BetaRavener/FITkit-plotter/Plotter/bottom.JPG

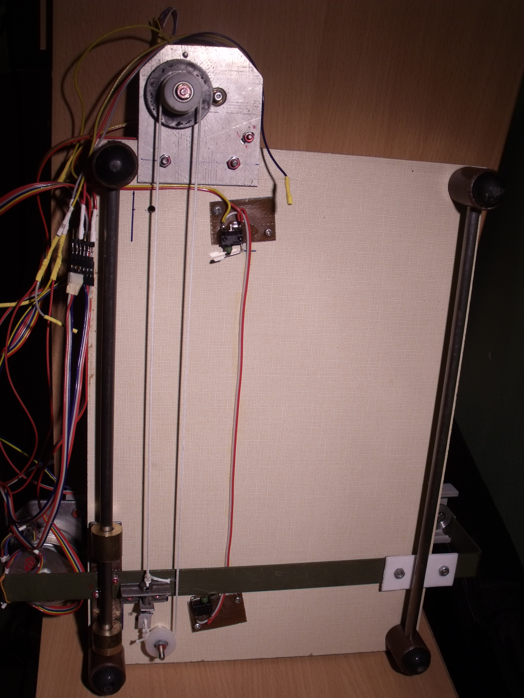
Plotter/bottom.JPG
