BetaRavener/FITkit-plotter/Plotter/stringY.JPG

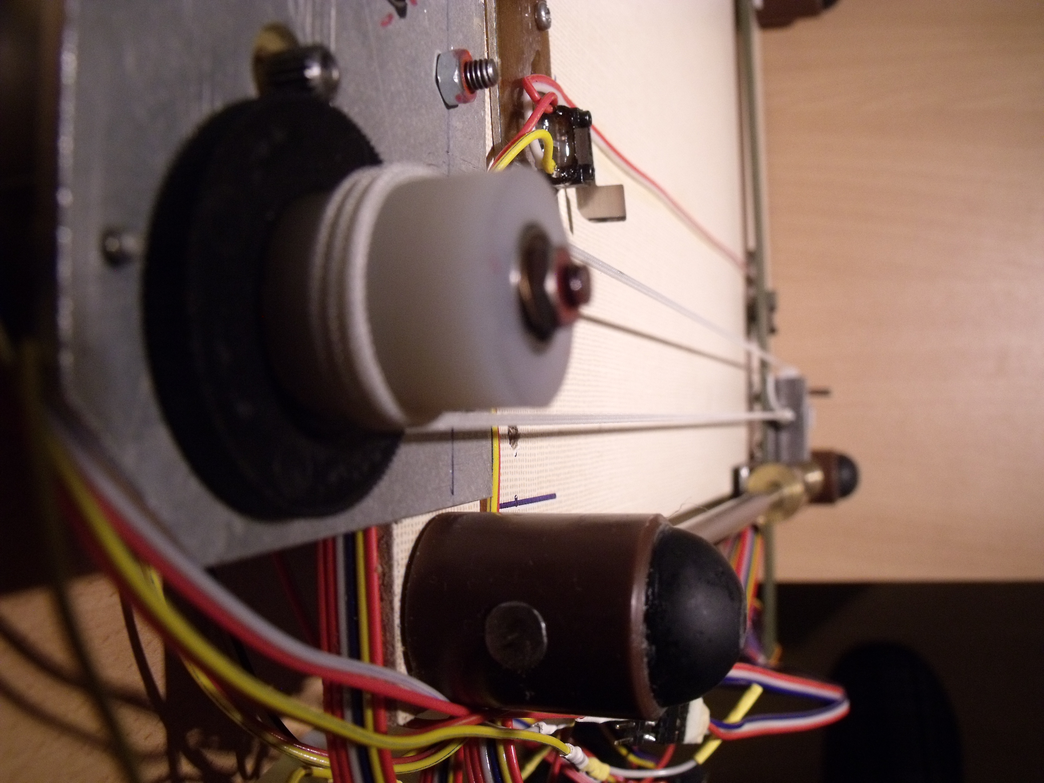
Plotter/stringY.JPG
