BetaRavener/FITkit-plotter/README.md

# FITkit-plotter Control programs for PC and FITkit device. 
Watch it in action: https://www.youtube.com/watch?v=PZSXbNqtS44 

FITkit is developlment platform created at Faculty of Information 
Technologies (FIT), Brno University of Technology. It is equiped with 
fast MCU and FPGA and also has plenty of ready-to-use peripheries. While 
quite complex, it can be conveniently programmed and controlled using 
USB. <a href=http://merlin.fit.vutbr.cz/FITkit/en/uvod.html>More about 
FITkit</a>.
