BetaRavener/FITkit-plotter/Plotter/readme.txt

The images in this folder are currently the only documentation of plotter 
construction. A new and more stable plotter construction with step-by-step
instructions is planned for the summer.
--------------------------------------------------------------------------------
Obrazky v tejto zlozke su momentalne jedinou dokumentaciou konstrukcie plotra.
Na leto sa planuje nova a stabilnejsia konstrukcia pre ktoru budu dostupne
podrobne instrukcie.
