BetaRavener/FITkit-plotter/Drawings/drawing1.png

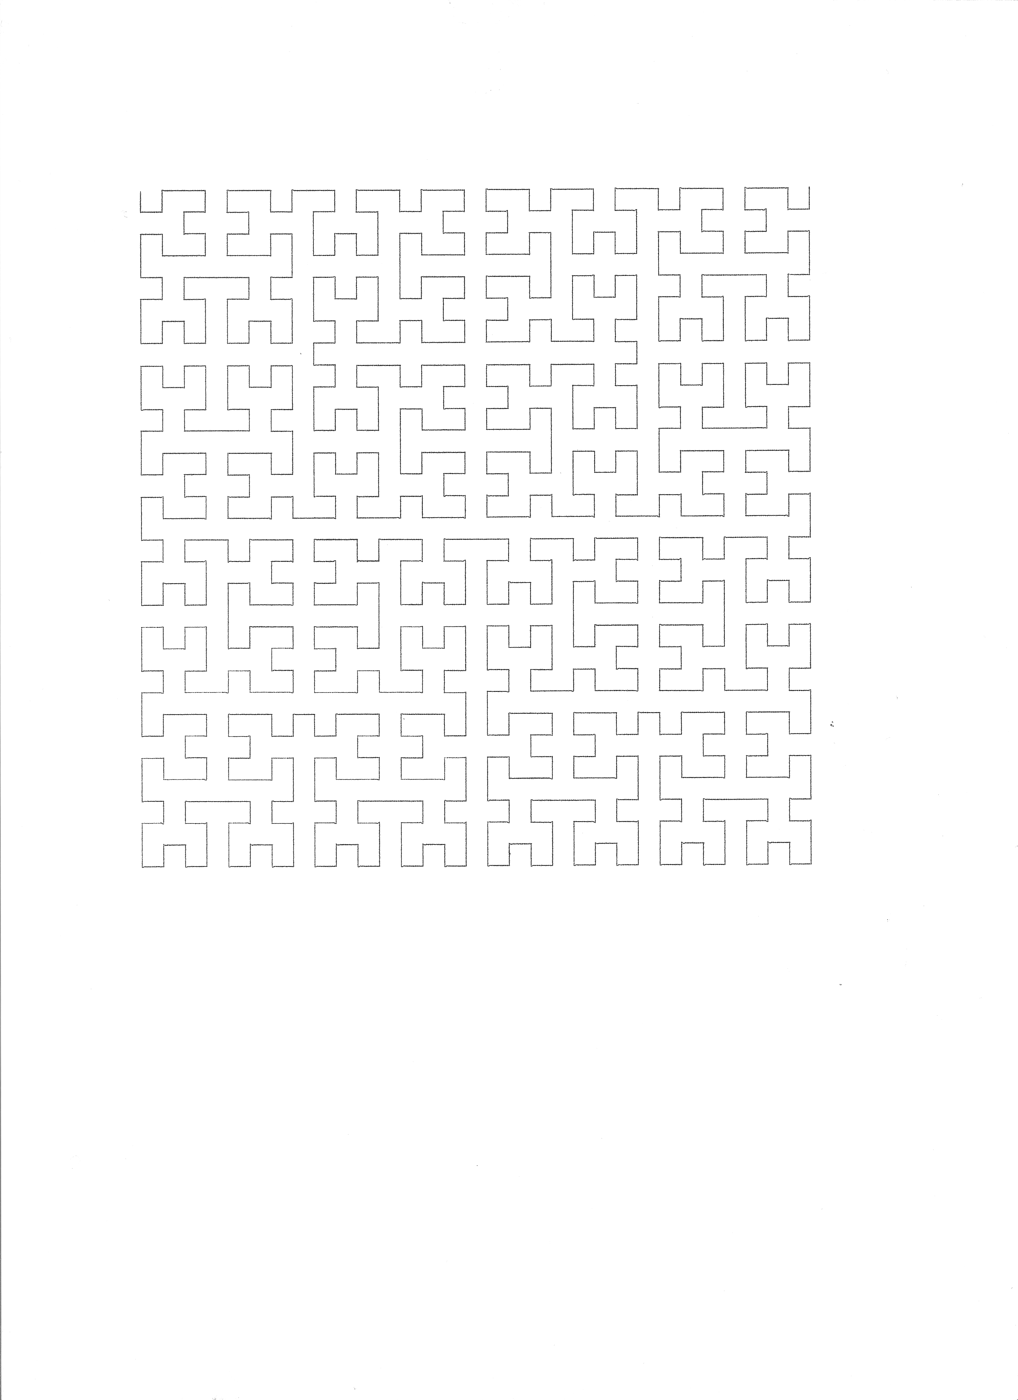
Drawings/drawing1.png
