BetaRavener/FITkit-plotter/Drawings/drawing2.jpg

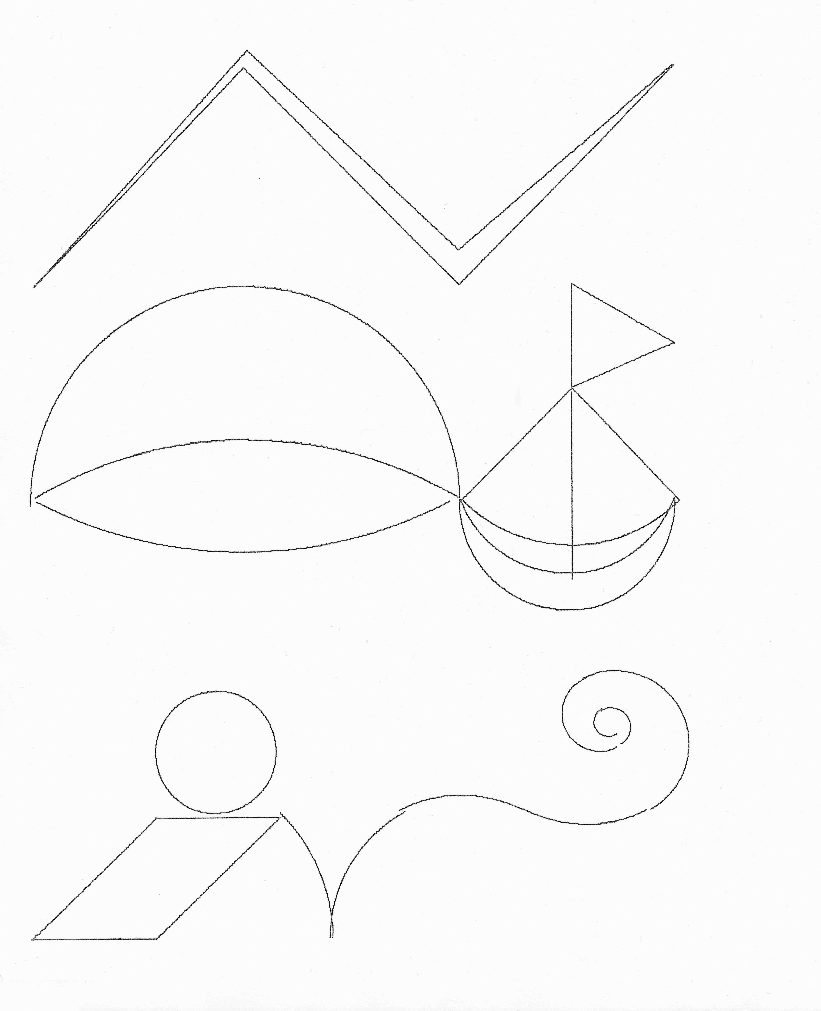
Drawings/drawing2.jpg
