BetaRavener/FITkit-plotter/Drawings/drawing3.png

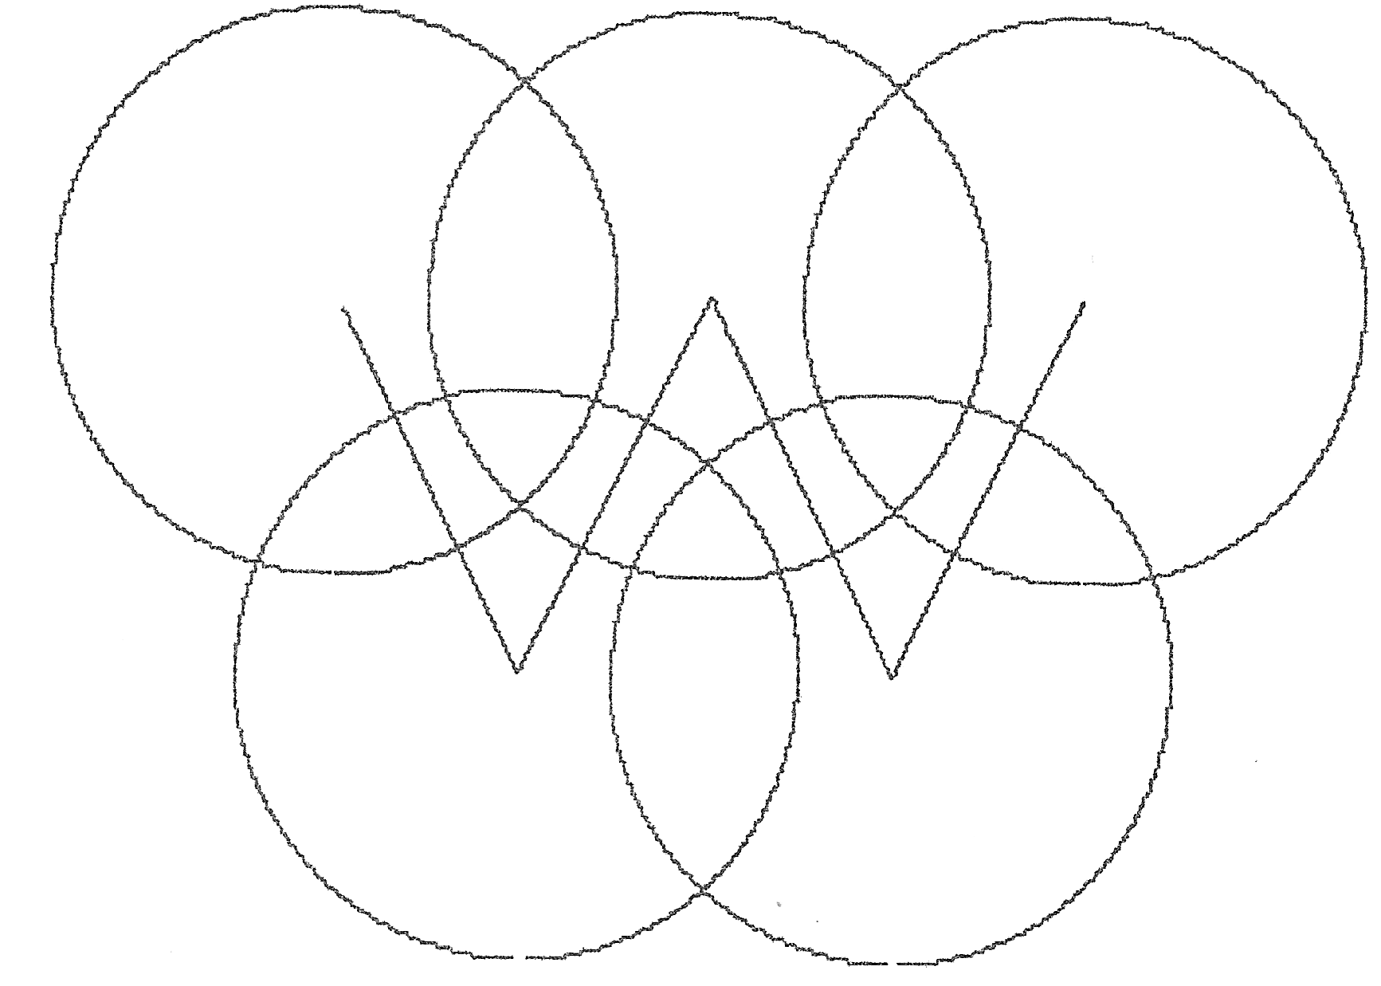
Drawings/drawing3.png
