BetaRavener/FITkit-plotter/Plotter/carriageTop.JPG

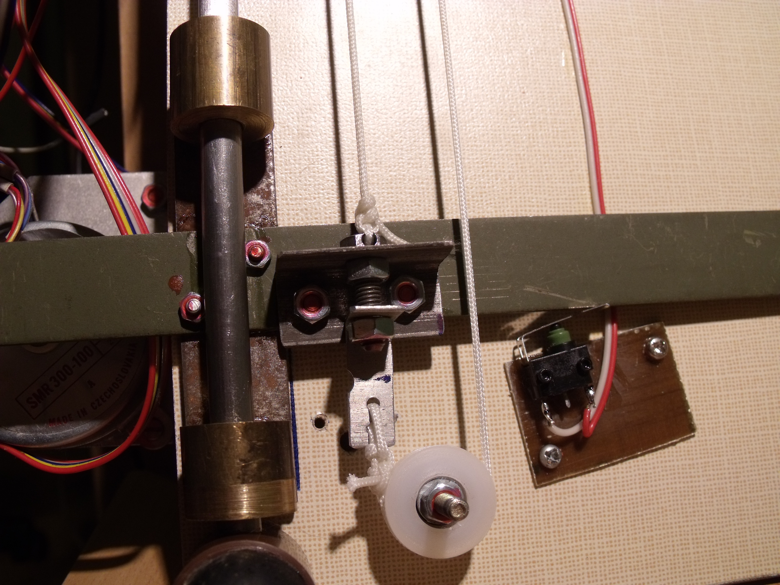
Plotter/carriageTop.JPG
