BetaRavener/FITkit-plotter/Plotter/gearX.jpg

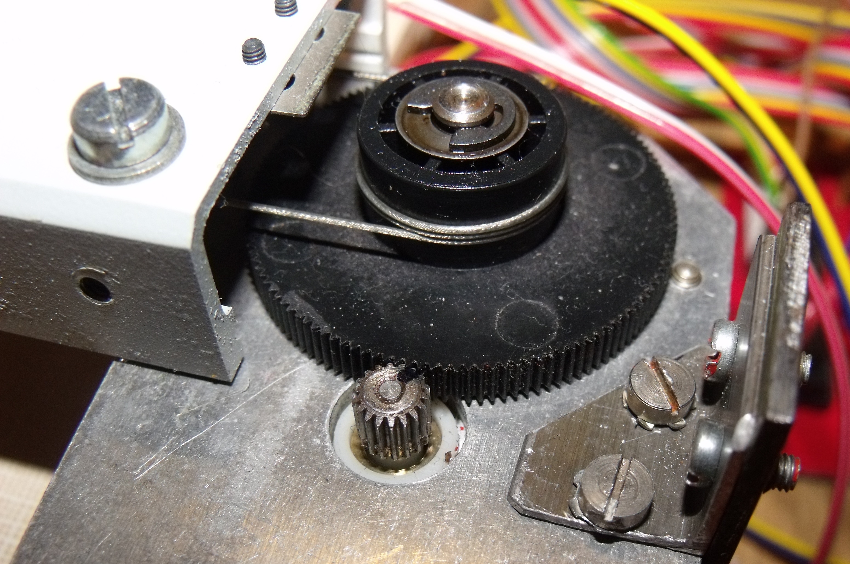
Plotter/gearX.jpg
