BetaRavener/FITkit-plotter/Plotter/gearY.JPG

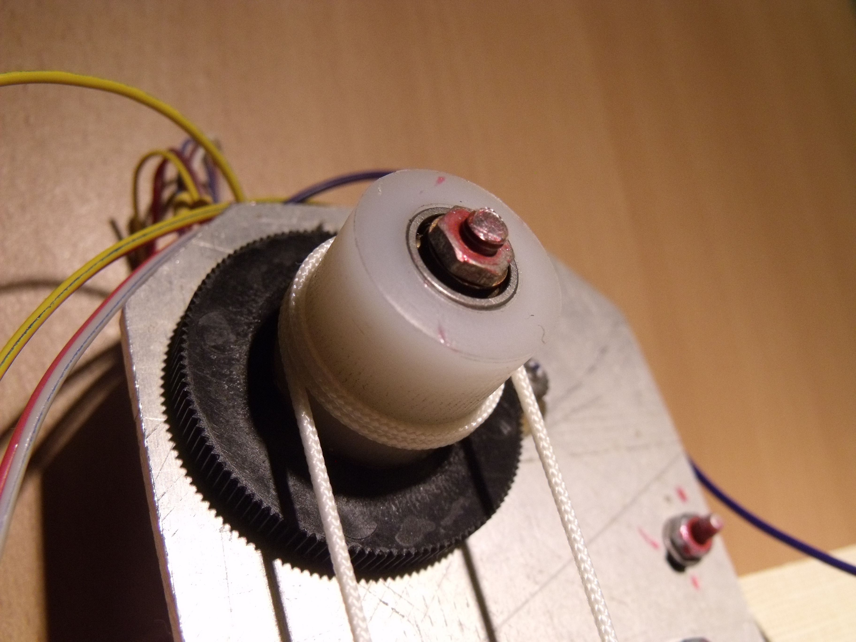
Plotter/gearY.JPG
