BetaRavener/FITkit-plotter/Plotter/headPen.JPG

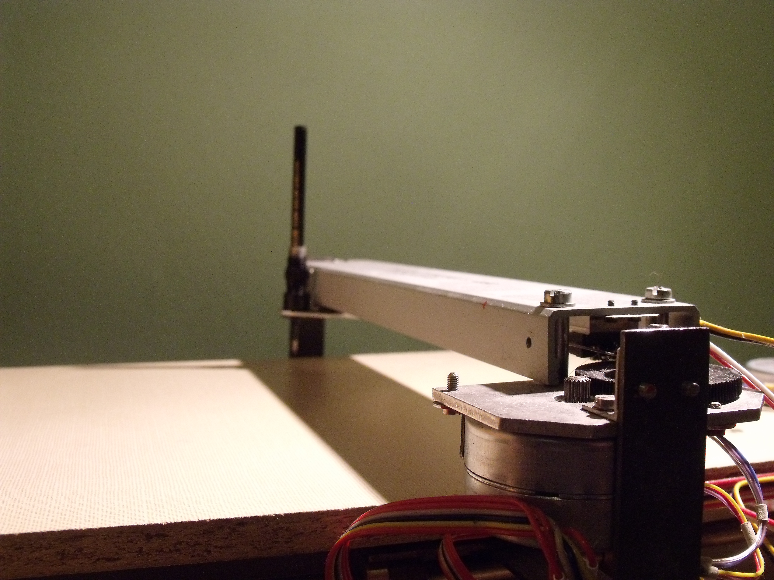
Plotter/headPen.JPG
