BetaRavener/FITkit-plotter/Plotter/plotter.JPG

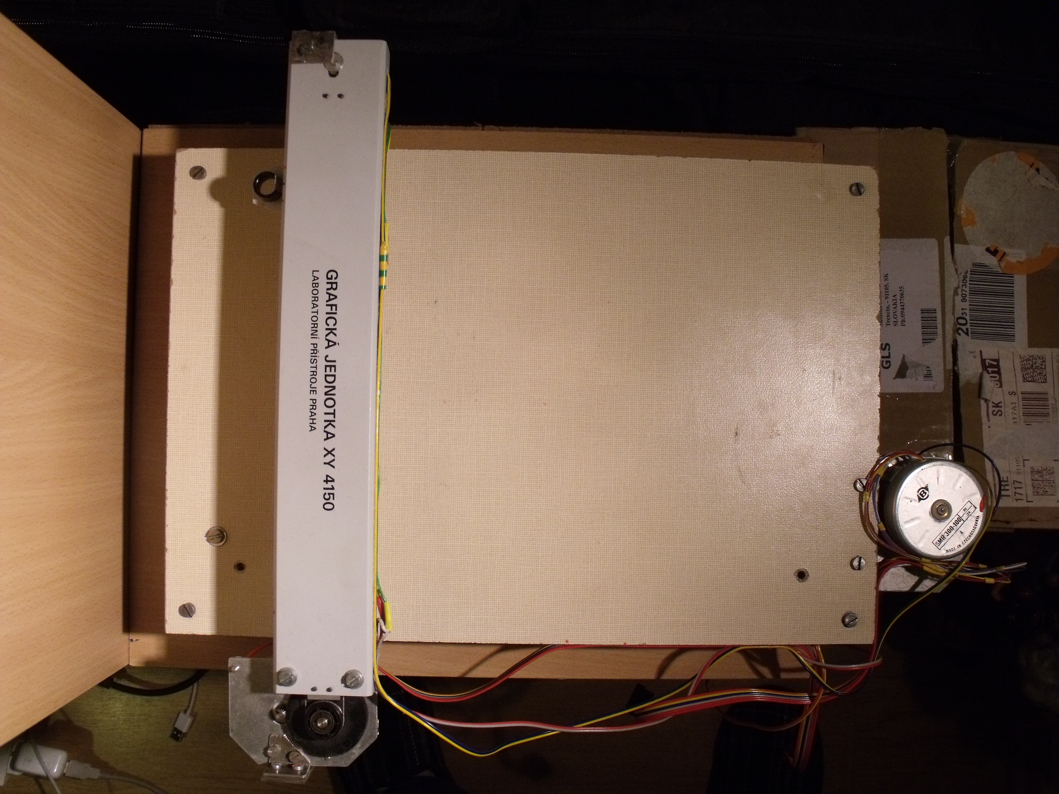
Plotter/plotter.JPG
