BetaRavener/FITkit-plotter/Plotter/shaftCarriage.jpg

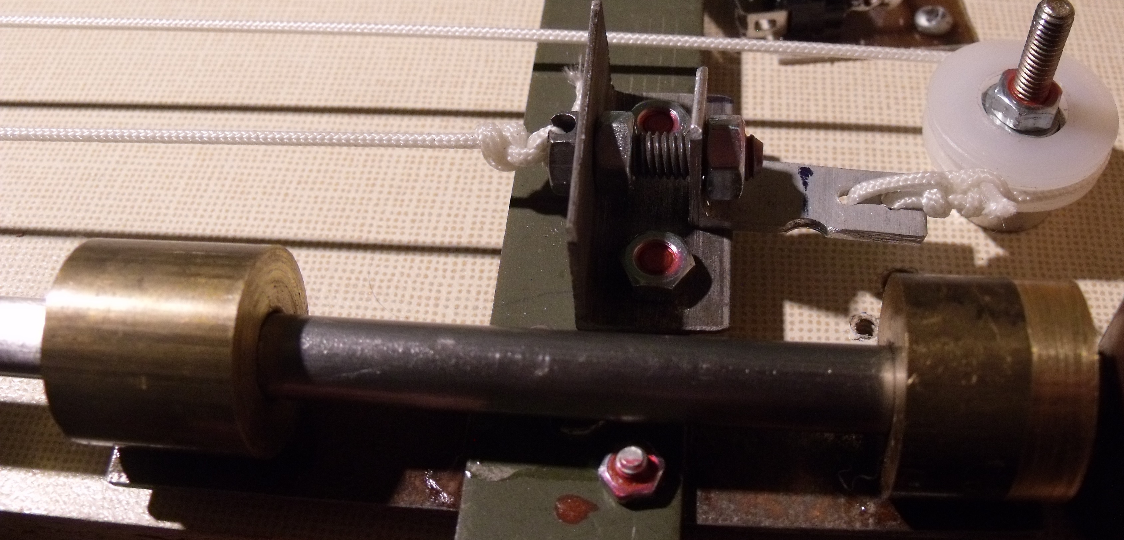
Plotter/shaftCarriage.jpg
