BetaRavener/FITkit-plotter/Plotter/shaftFree.JPG

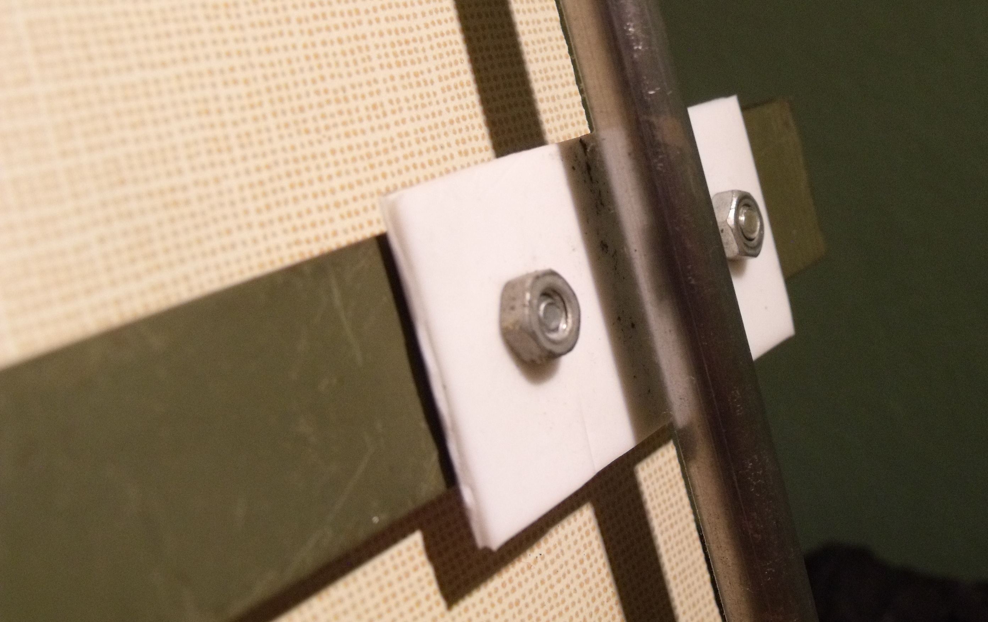
Plotter/shaftFree.JPG
