BetaRavener/FITkit-plotter/Schemes/ampBoard.png

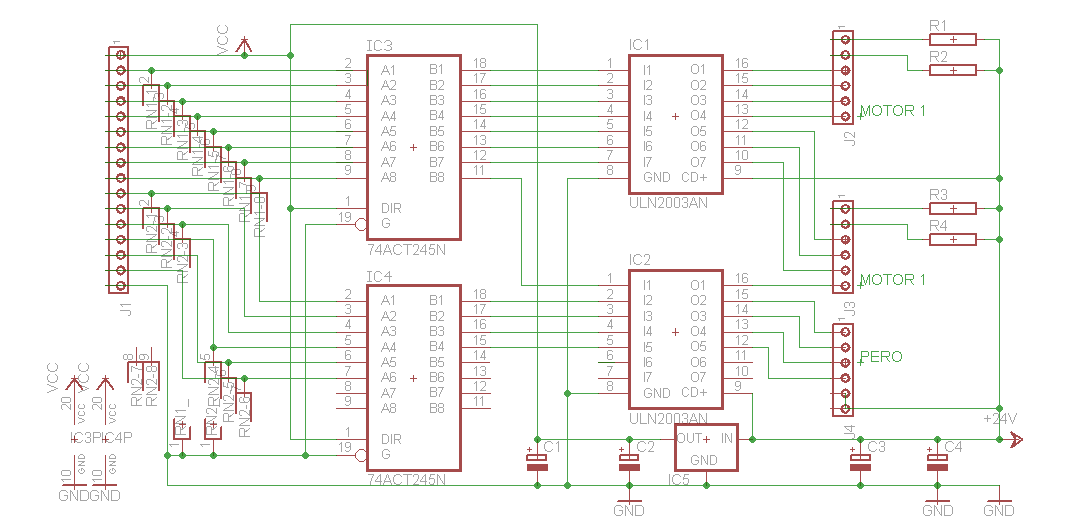
Schemes/ampBoard.png
