BetaRavener/FITkit-plotter/Schemes/motors.png

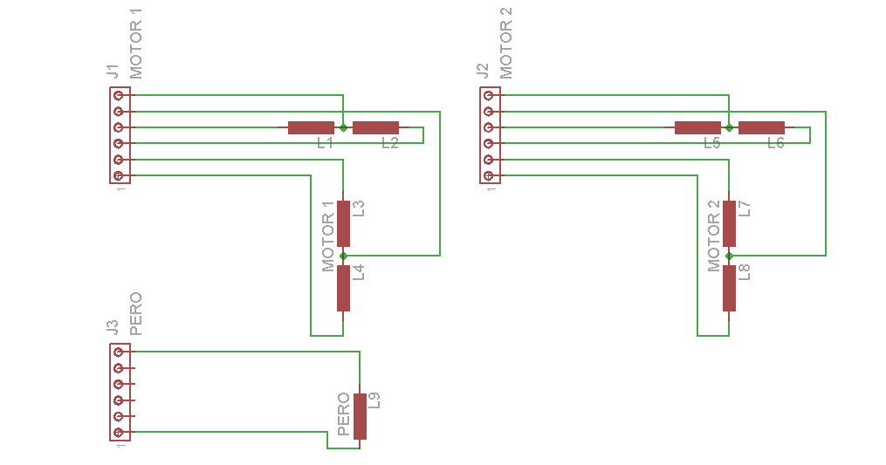
Schemes/motors.png
