BetaRavener/FITkit-plotter/PC/Drawing2.dxf

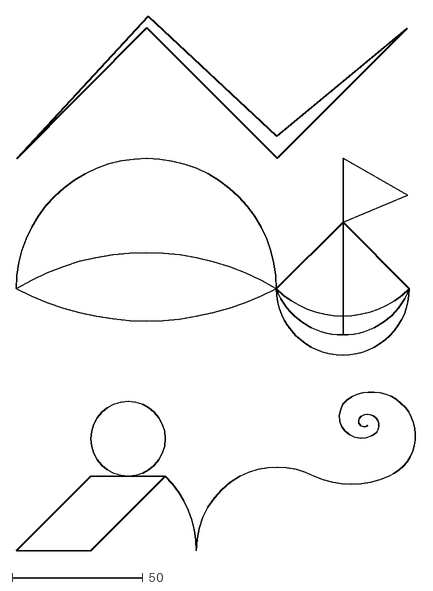
[picture p16: CAD file, 2015-03-24]
PC/Drawing2.dxf
153.2 x 204.3
